petersenna/eQ-3-RAV-adapter/images/adapter.jpg

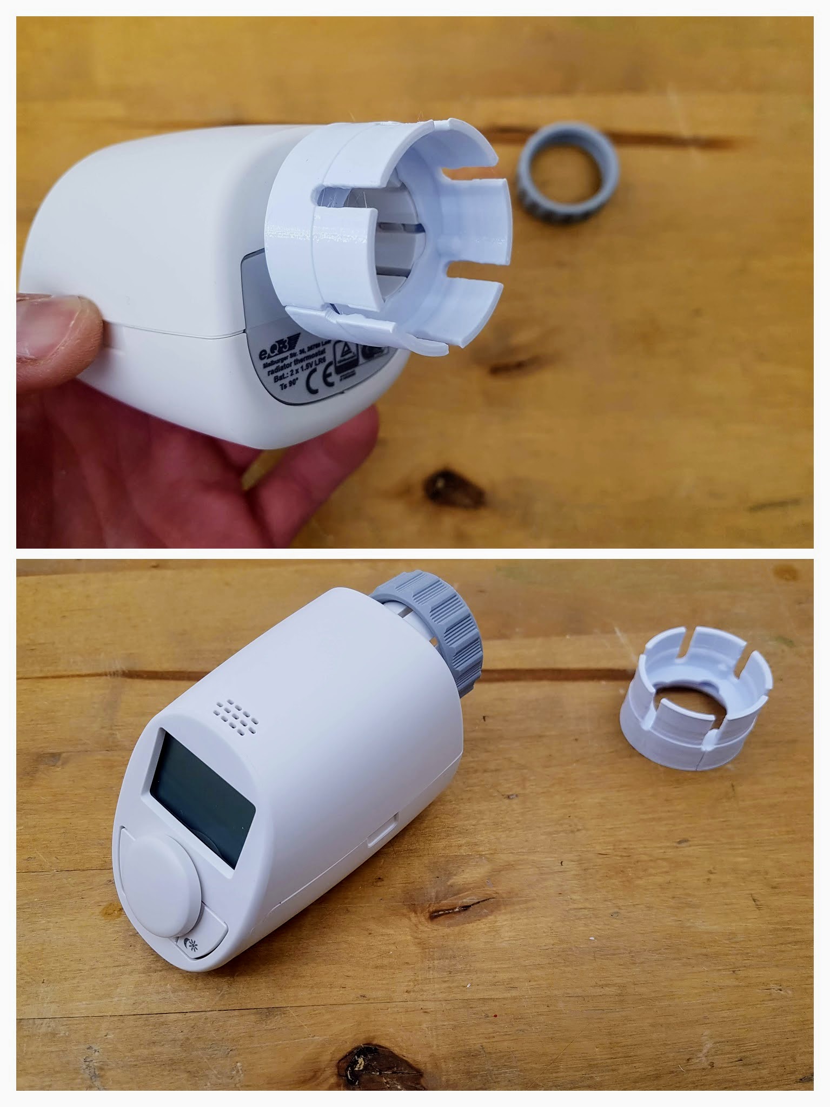
images/adapter.jpg
