petersenna/eQ-3-RAV-adapter/images/rav.jpg

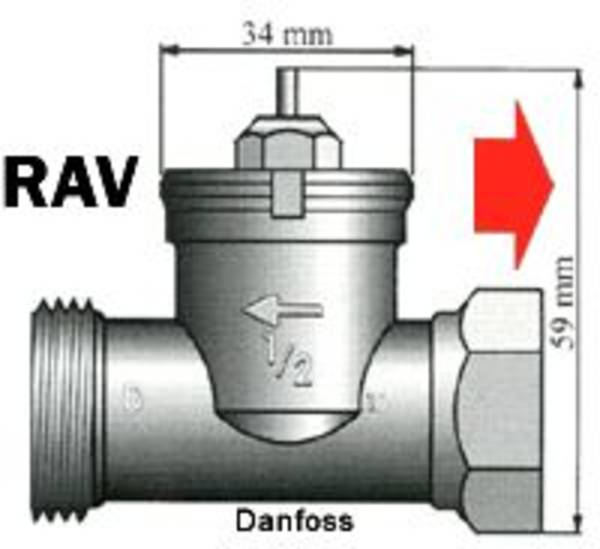
images/rav.jpg
