petersenna/eQ-3-RAV-adapter/README.md

[eQ-3 thermostat to Danfoss RAV valve adapter](https://www.prusaprinters.org/prints/110674-eq-3-eq3-thermostat-to-danfoss-rav-valve-adapter-v)
