petersenna/eQ-3-RAV-adapter/images/valve-thermostats.jpg

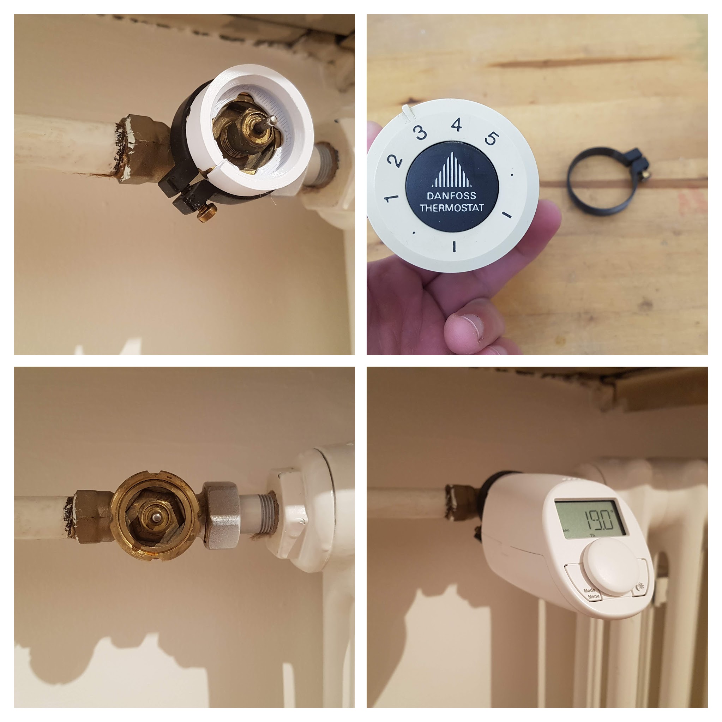
images/valve-thermostats.jpg
