petersenna/eQ-3-RAV-adapter/(commit log)

2019-11-14 Split code into modules
    * module eQ3 is the connector to the eQ-3 thermostat
    * module interface is the interface between the thermostat and the
    valve
    * module RAV is the connector to the valve
    interface_h is an important number. On my valves this was adjusted to
    match the distance between the eQ-3 motor and the valve pin. A value
    smaller than 1mm would mean that the eQ-3 would not be capable of fully
    opening the valve.
    Also there should be a gap of 3.2 mm between the interface and the dent
    on the eQ-3 side for hosting the eQ-3 clips.
    I have four instances of this part running at my place but while it is
    working, I found some issues:
    * The RAV connector barely stays in place. Maybe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
    [eQ-3-RAV-adapter.scad]
2019-11-14 image of rav valve
2019-11-14 added images of the adapter, valve and thermostats
2019-11-15 Enlarge eQ-3 clip groove
    [eQ-3-RAV-adapter.scad]
2019-11-15 RAV: Lower the torus and rotate the vanes
    [eQ-3-RAV-adapter.scad]
2019-11-15 Interface: simplify shape to improve printing
    [eQ-3-RAV-adapter.scad]
2019-11-15 RAV: Move side cuts up
    [eQ-3-RAV-adapter.scad]
2019-11-15 Revert "Interface: simplify shape to improve printing"
    This reverts commit 139782a6958ea30cdda713b1e11f336aee7b9a19 as the
    supports needed after this change were much harder to remove.
    [eQ-3-RAV-adapter.scad]
2019-11-15 Revert "Enlarge eQ-3 clip groove"
    This reverts commit 42ee652cd5de39a03c75ca4de83837d08739f451 as the
    diameter of the clip is 30 and 32.5 leaces too much play. However the
    change in position is good and will be reintroduced in other commit.
    [eQ-3-RAV-adapter.scad]
2019-11-15 eQ3: Change clip groove depth and height
    [eQ-3-RAV-adapter.scad]
2019-11-15 interface: second attempt to make the interface support easier to print and remove
    [eQ-3-RAV-adapter.scad]
2019-11-15 eQ3: Change clip groove depth
    [eQ-3-RAV-adapter.scad]
